ItIsMeMyselfAndI/wireless-air-mouse/public/schematic_c3.png

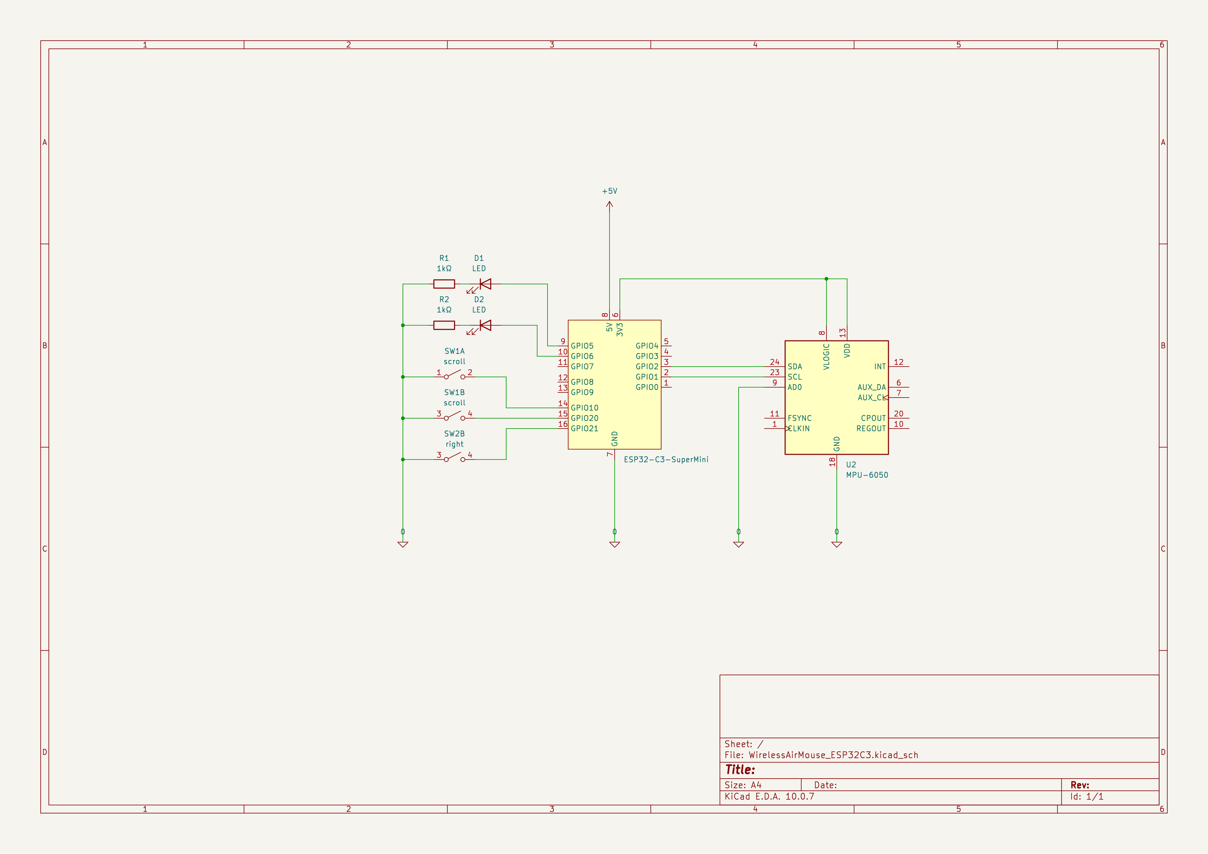
public/schematic_c3.png
