ItIsMeMyselfAndI/wireless-air-mouse/public/schematic_s3.png

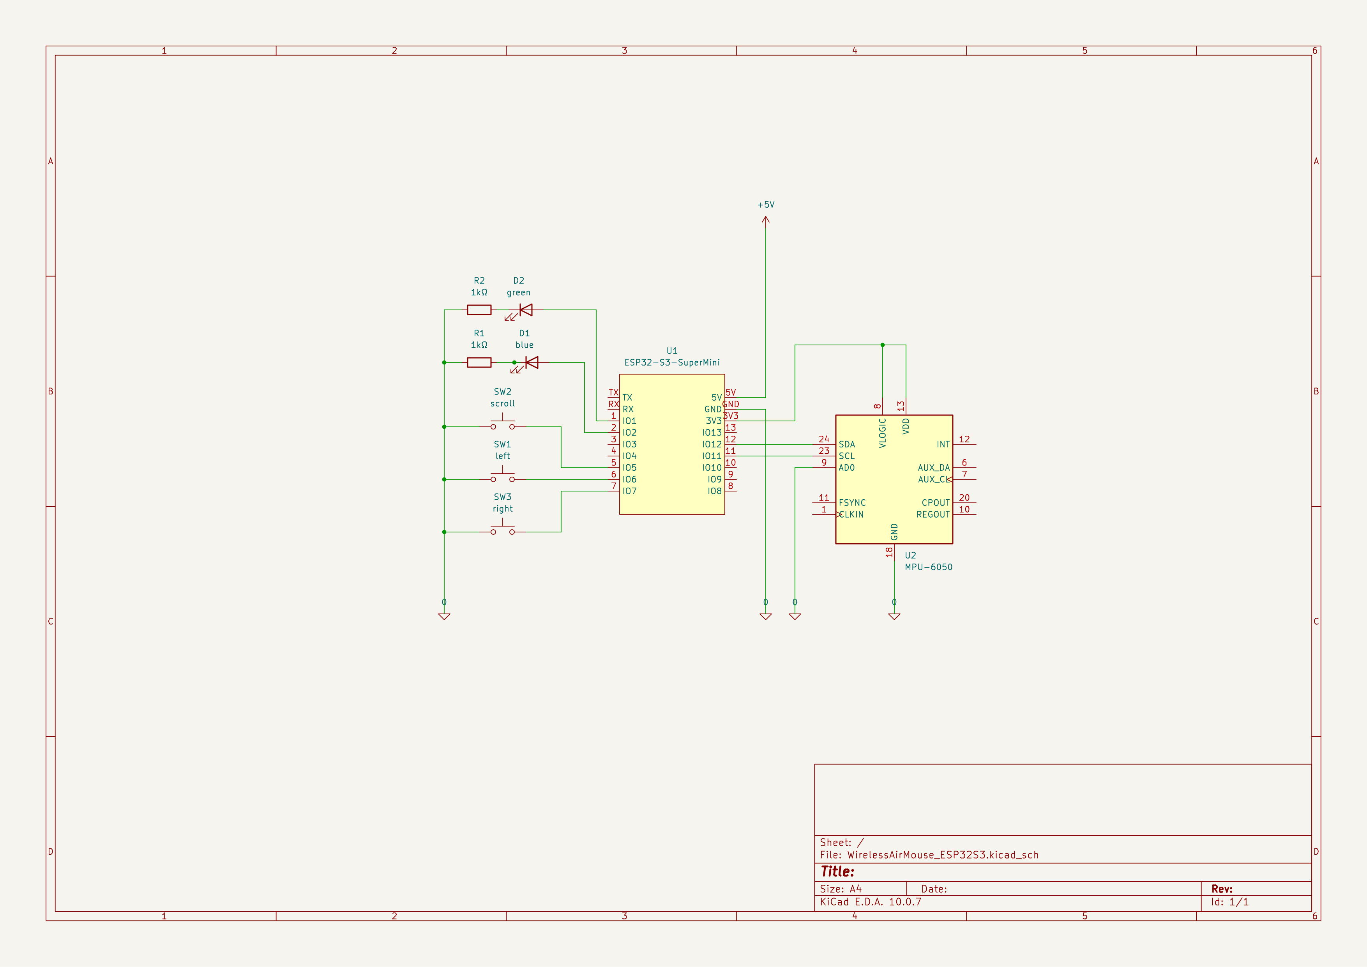
public/schematic_s3.png
