ItIsMeMyselfAndI/wireless-air-mouse/WirelessAirMouse/WirelessAirMouse.kicad_sch

## KiCad design WirelessAirMouse/WirelessAirMouse.kicad_sch (2026-10-17)

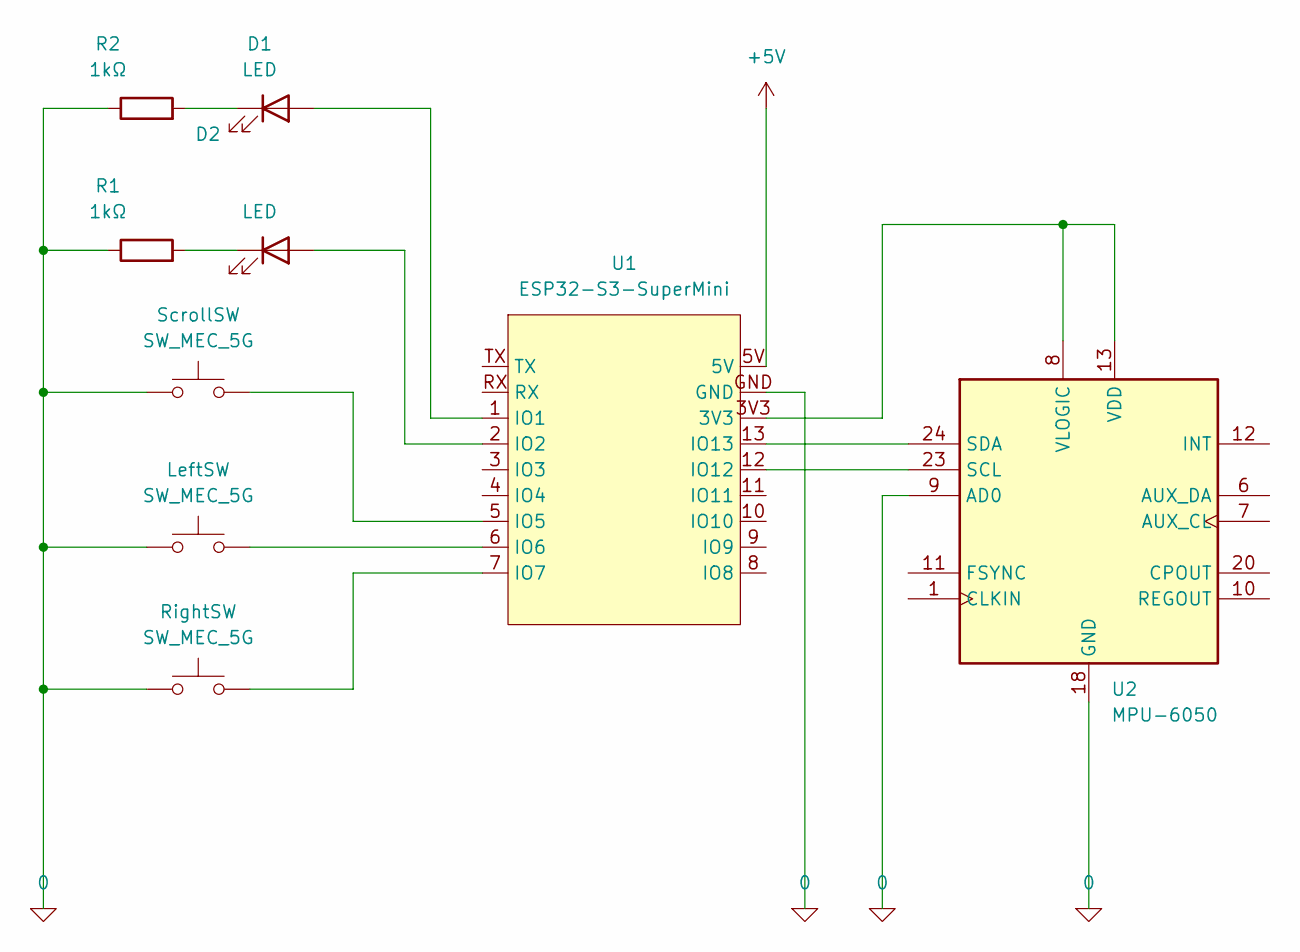
[picture p5: schematic WirelessAirMouse.kicad_sch]

Parts:
D1, D2: LED
LeftSW: SW_MEC_5G
R1, R2: 1kΩ
RightSW: SW_MEC_5G
ScrollSW: SW_MEC_5G
U1: ESP32-S3-SuperMini
U2: MPU-6050; InvenSense_QFN-24_4x4mm_P0.5mm

Connections:
0: LeftSW.1 (A), LeftSW.2 (A), R1.1, R2.1, RightSW.1 (A), RightSW.2 (A), ScrollSW.1 (A), ScrollSW.2 (A), U1.GND, U2.9 (AD0), U2.18 (GND)
+5V: U1.5V
unnamed: D1.1 (K), R2.2
unnamed: D1.2 (A), U1.1 (IO1)
unnamed: D2.1 (K), R1.2
unnamed: D2.2 (A), U1.2 (IO2)
unnamed: LeftSW.3 (B), LeftSW.4 (B), U1.6 (IO6)
unnamed: RightSW.3 (B), RightSW.4 (B), U1.7 (IO7)
unnamed: ScrollSW.3 (B), ScrollSW.4 (B), U1.5 (IO5)
unnamed: U1.3V3, U2.8 (VLOGIC), U2.13 (VDD)
unnamed: U1.12 (IO12), U2.23 (SCL)
unnamed: U1.13 (IO13), U2.24 (SDA)
