ItIsMeMyselfAndI/wireless-air-mouse/(commit log)

2026-10-13 feat: add bluetooth mouse capabilities - left click: button 0 - right click: button 1 - scroll: button 2 (hold and tilt) - cursor movement: move mouse
2026-10-14 refactor: modularize handlers and update pin assignments
    - Reassign I2C pins: SDA to GPIO 3, SCL to GPIO 2
    - Reassign button pins: Scroll to GPIO 5, Left to GPIO 6, Right to GPIO 7
    - Refactor logic into dedicated handlers (motion, scroll, buttons)
    - Add button state struct with debouncing and serial logs for clicks and scroll ticks
2026-10-14 feat(hardware): add KiCad schematic and project files
    - Add schematic for ESP32-C3 Super Mini and MPU-6050 wiring
    - Include push button switches for Left, Right, and Scroll
    - Add .gitignore for KiCad autosave and lock files
    [WirelessAirMouse.kicad_pcb, WirelessAirMouse.kicad_sch]
2026-10-14 docs: update readme with schematic diagram and revised pinout
    - Embed schematic vector image in README
    - Update hardware pinout table and controls guide with current GPIO mapping
    - Add exported high-resolution PNG and SVG schematic assets
2026-10-17 feat: migrate to ESP32-S3 Super Mini and add LED indicators
    - Remap I2C to GPIO 12 (SDA) and GPIO 11 (SCL) for S3 Super Mini
    - Add onboard WS2812 RGB LED (GPIO 48) support with status colors
    - Add external LEDs: GPIO 1 (calibrated status) and GPIO 2 (button clicks)
    - Fix right-click registration by switching from click() to press()/release()
    - Print BLE MAC address on startup
    - Tune deadzones and add settle delay with visual feedback during calibration
    [WirelessAirMouse.ino]
2026-10-17 feat: add sleep mode, connection-triggered calibration, and BLE advertising fixes
    - Configure explicit BLE advertising name and scan response for Windows 11 & Android
    - Keep MPU-6050 in hardware sleep until a host connects
    - Trigger sensor calibration only upon active BLE connection
    - Automatically put sensor to sleep and restart advertising on disconnect
    [WirelessAirMouse.ino]
2026-10-17 docs: update schematic for ESP32-S3 Super Mini and add breadboard photo
    - Re-export schematic SVG and 300 DPI PNG from updated KiCad schematic
    - Embed breadboard prototype photo into README
    - Update KiCad project files and symbol library table
    [WirelessAirMouse.kicad_sch]
2026-10-17 feat: migrate back to ESP32-C3 Super Mini with remapped GPIOs
2026-10-17 feat: add unified pin mapping and board abstraction for ESP32-C3 and ESP32-S3
2026-10-17 chore: set ESP32-C3 as default board define
2026-10-17 chore: rename schematic and breadboard images to _s3
2026-10-17 feat: add ESP32-C3 schematics, breadboard prototype, and separate C3/S3 KiCad projects
    [WirelessAirMouse_ESP32C3.kicad_pcb, WirelessAirMouse_ESP32C3.kicad_sch, WirelessAirMouse_ESP32S3.kicad_pcb, WirelessAirMouse_ESP32S3.kicad_sch]
2026-10-22 refactor: organize assets into public and kicad directories, add demo videos and update README
    [WirelessAirMouse_ESP32C3.kicad_pcb, WirelessAirMouse_ESP32C3.kicad_sch, WirelessAirMouse_ESP32S3.kicad_pcb, WirelessAirMouse_ESP32S3.kicad_sch]
